SuperSodaSea/Plugcat/README.md

# 🔌Plugcat




- [QSFP-HDMI-OUT-NB7NQ621M v1.1](./QSFP-HDMI-OUT-NB7NQ621M/README.md)
