SuperSodaSea/Plugcat/QSFP-HDMI-OUT-NB7NQ621M/README-zh.md

# QSFP-HDMI-OUT-NB7NQ621M

Module Photo 1

<p align="center">
    <a href="./README.md">English</a> |
    中文
</p>

---




还在为 FPGA 板卡缺少视频输出接口而发愁吗？这款小巧精致的创新模块可以帮您！QSFP-HDMI-OUT-NB7NQ621M 是一款具有 HDMI 输出接口的 QSFP 模块：只需将其插入 FPGA 板卡上的 QSFP 插槽中，即可立即使板卡获得 HDMI 输出功能。这将极大提高您 FPGA 板卡的可扩展性。

## 特性

- 使用 [NB7NQ621M](https://www.onsemi.com/products/signal-conditioning-control/redrivers/NB7NQ621M) 重驱动器芯片，支持HDMI 2.1 视频信号输出，带宽高达 48Gbps
- 提供 HDMI 2.0 TMDS 示例代码，支持 1920x1080@240Hz、2560x1440@144Hz、3840x2160@60Hz 等显示模式
- HDMI 2.1 FRL 待后续提供，您可以使用任意 HDMI 2.1 IP 核

## 引脚描述

| 名称 | 描述 |
|---|---|
| TX1p | HDMI CK+ |
| TX1n | HDMI CK- |
| TX2p | HDMI D0+ |
| TX2n | HDMI D0- |
| TX3p | HDMI D1+ |
| TX3n | HDMI D1- |
| TX4p | HDMI D2+ |
| TX4n | HDMI D2- |
| ModPrsL | 为低电平时，HDMI 线缆为插入状态 |
| ResetL  | 为低电平时，重置 NB7NQ621M |
| SCL | NB7NQ621M 和 HDMI DDC 的 I2C 时钟 |
| SDA | NB7NQ621M 和 HDMI DDC 的 I2C 数据 |

## PCB 信息

- 厚度: 1.00mm
- 叠层结构: JLC04101H-3313

## 已验证的 FPGA 板卡

<table>
  <thead>
    <tr>
      <th>FPGA</th>
      <th>板卡</th>
      <th>示例代码</th>
    </tr>
  </thead>
  <tbody>
    <tr>
      <th colspan="3" scope="rowgroup">Xilinx Zynq 7000 SoC</th>
    </tr>
    <tr>
      <td>XC7Z100</td>
      <td>公子哥 玄武 ZYNQ7100 + FMC 转 QSFP 子板</td>
      <td></td>
    </tr>
    <tr>
      <th colspan="3" scope="rowgroup">Xilinx Kintex Ultrascale</th>
    </tr>
    <tr>
      <td>XCKU060</td>
      <td>Alpha Data ADM-PCIE-KU3</td>
      <td align="center"><a href="./examples/ADM-PCIE-KU3/">🔗</a></td>
    </tr>
    <tr>
      <th colspan="3" scope="rowgroup">Xilinx Virtex Ultrascale</th>
    </tr>
    <tr>
      <td>XCVU095</td>
      <td>BittWare XUS-P3S</td>
      <td></td>
    </tr>
    <tr>
      <th colspan="3" scope="rowgroup">Xilinx Kintex UltraScale+</th>
    </tr>
    <tr>
      <td>XCKU5P</td>
      <td>博宸精芯 KU5P</td>
      <td align="center"><a href="./examples/BoChenJingXin-KU5P/">🔗</a></td>
    </tr>
    <tr>
      <td>XCKU5P</td>
      <td>RIGUKE RK-XCKU5P-F</td>
      <td align="center"><a href="./examples/RK-XCKU5P-F/">🔗</a></td>
    </tr>
    <tr>
      <td>XCKU5P</td>
      <td>米联客 MLK-H8-CU06-KU5P</td>
      <td align="center"><a href="./examples/MLK-H8-CU06-KU5P/">🔗</a></td>
    </tr>
    <tr>
      <th colspan="3" scope="rowgroup">Xilinx Virtex UltraScale+</th>
    </tr>
    <tr>
      <td>XCVU13P</td>
      <td>阿里巴巴 VU13P</td>
      <td align="center"><a href="./examples/Alibaba-VU13P/">🔗</a></td>
    </tr>
    <tr>
      <th colspan="3" scope="rowgroup">Altera Stratix V GS</th>
    </tr>
    <tr>
      <td>5SGSKF40I3LNAC</td>
      <td>微软 Catapult v2 Storey Peak / X930613-001</td>
      <td align="center"><a href="./examples/Storey-Peak/">🔗</a></td>
    </tr>
    <tr>
      <th colspan="3" scope="rowgroup">Altera Arria 10 GX</th>
    </tr>
    <tr>
      <td>10AXF40AA</td>
      <td>微软 Catapult v3 Longs Peak / Model: 1768</td>
      <td align="center"><a href="./examples/Longs-Peak/">🔗</a></td>
    </tr>
    <tr>
      <th colspan="3" scope="rowgroup">Altera Stratix 10 GX</th>
    </tr>
    <tr>
      <td>1SG280LN2F43E2VG</td>
      <td>微软 A-2020</td>
      <td align="center"><a href="./examples/Microsoft-A-2020/">🔗</a></td>
    </tr>
    <tr>
      <th colspan="3" scope="rowgroup">紫光同创 Titan-2</th>
    </tr>
    <tr>
      <td>PG2T390H</td>
      <td>小眼睛泰坦 390H + FMC 转 QSFP 子板</td>
      <td></td>
    </tr>
  </tbody>
</table>

## 示例代码

示例代码在 Windows 与 Linux 下均可构建。

### 依赖工具

- [Python 3](https://www.python.org/)（用于构建脚本）
- [Java](https://www.java.com/)（用于 Chisel）
- [Mill](https://mill-build.org/mill/index.html)（用于 Chisel）
- [Vivado](https://www.amd.com/en/products/software/adaptive-socs-and-fpgas/vivado.html)（用于构建 Xilinx FPGA 工程）
- [Quartus Prime](https://www.intel.com/content/www/us/en/products/details/fpga/development-tools/quartus-prime.html)（用于构建 Altera FPGA 工程）

### 构建示例代码

在对应示例代码目录下运行以下命令即可构建示例代码：

```bash
python build.py build
```

示例代码的默认视频模式为 `1920x1080@60Hz`。若需要更改分辨率和刷新率，可通过命令行参数指定：

```bash
python build.py build --resolution 2560x1440 --refresh-rate 144
```

支持的视频模式：
 - `1920x1080@30/60/120/144/240Hz`
 - `2560x1440@30/60/120/144Hz`
 - `3840x2160@30/60Hz`

其他分辨率可自行修改代码实现。

### 下载位流

```shell
python build.py program
```

### 固化位流

```shell
python build.py flash
```

## 更新日志

见 [CHANGELOG-zh.md](./CHANGELOG-zh.md)。

## 画廊

Module Photo 2
Module Photo 3
