SuperSodaSea/Plugcat/(list of files, cad)

Other CAD files:
QSFP-HDMI-OUT-NB7NQ621M/shell/QSFP-HDMI-OUT-NB7NQ621M-Shell-1.stl
QSFP-HDMI-OUT-NB7NQ621M/shell/QSFP-HDMI-OUT-NB7NQ621M-Shell-2.stl
