SuperSodaSea/Plugcat/QSFP-HDMI-OUT-NB7NQ621M/CHANGELOG.md

# Changelog

## v1.1

QSFP-HDMI-OUT-NB7NQ621M v1.1 is fully compatible with v1.0.

### PCB

- Add KiKit panelization configuration file
- Minor adjustment to circuit routing, optimizing signal quality

### Shell

- Minor adjustment to shell design, enhancing structural stability and manufacturability

## v1.0

Initial release.
