SuperSodaSea/Plugcat/QSFP-HDMI-OUT-NB7NQ621M/CHANGELOG-zh.md

# 更新日志

## v1.1

QSFP-HDMI-OUT-NB7NQ621M v1.1 与 v1.0 完全兼容。

### 电路板

- 添加 KiKit 拼版配置文件
- 微调电路板走线，优化信号质量

### 外壳

- 微调外壳模型，增强结构稳定性和可制造性

## v1.0

初次发布。
