SuperSodaSea/Plugcat/QSFP-HDMI-OUT-NB7NQ621M/board/QSFP-HDMI-OUT-NB7NQ621M.kicad_pcb

## KiCad design QSFP-HDMI-OUT-NB7NQ621M/board/QSFP-HDMI-OUT-NB7NQ621M.kicad_pcb (2026-05-23)

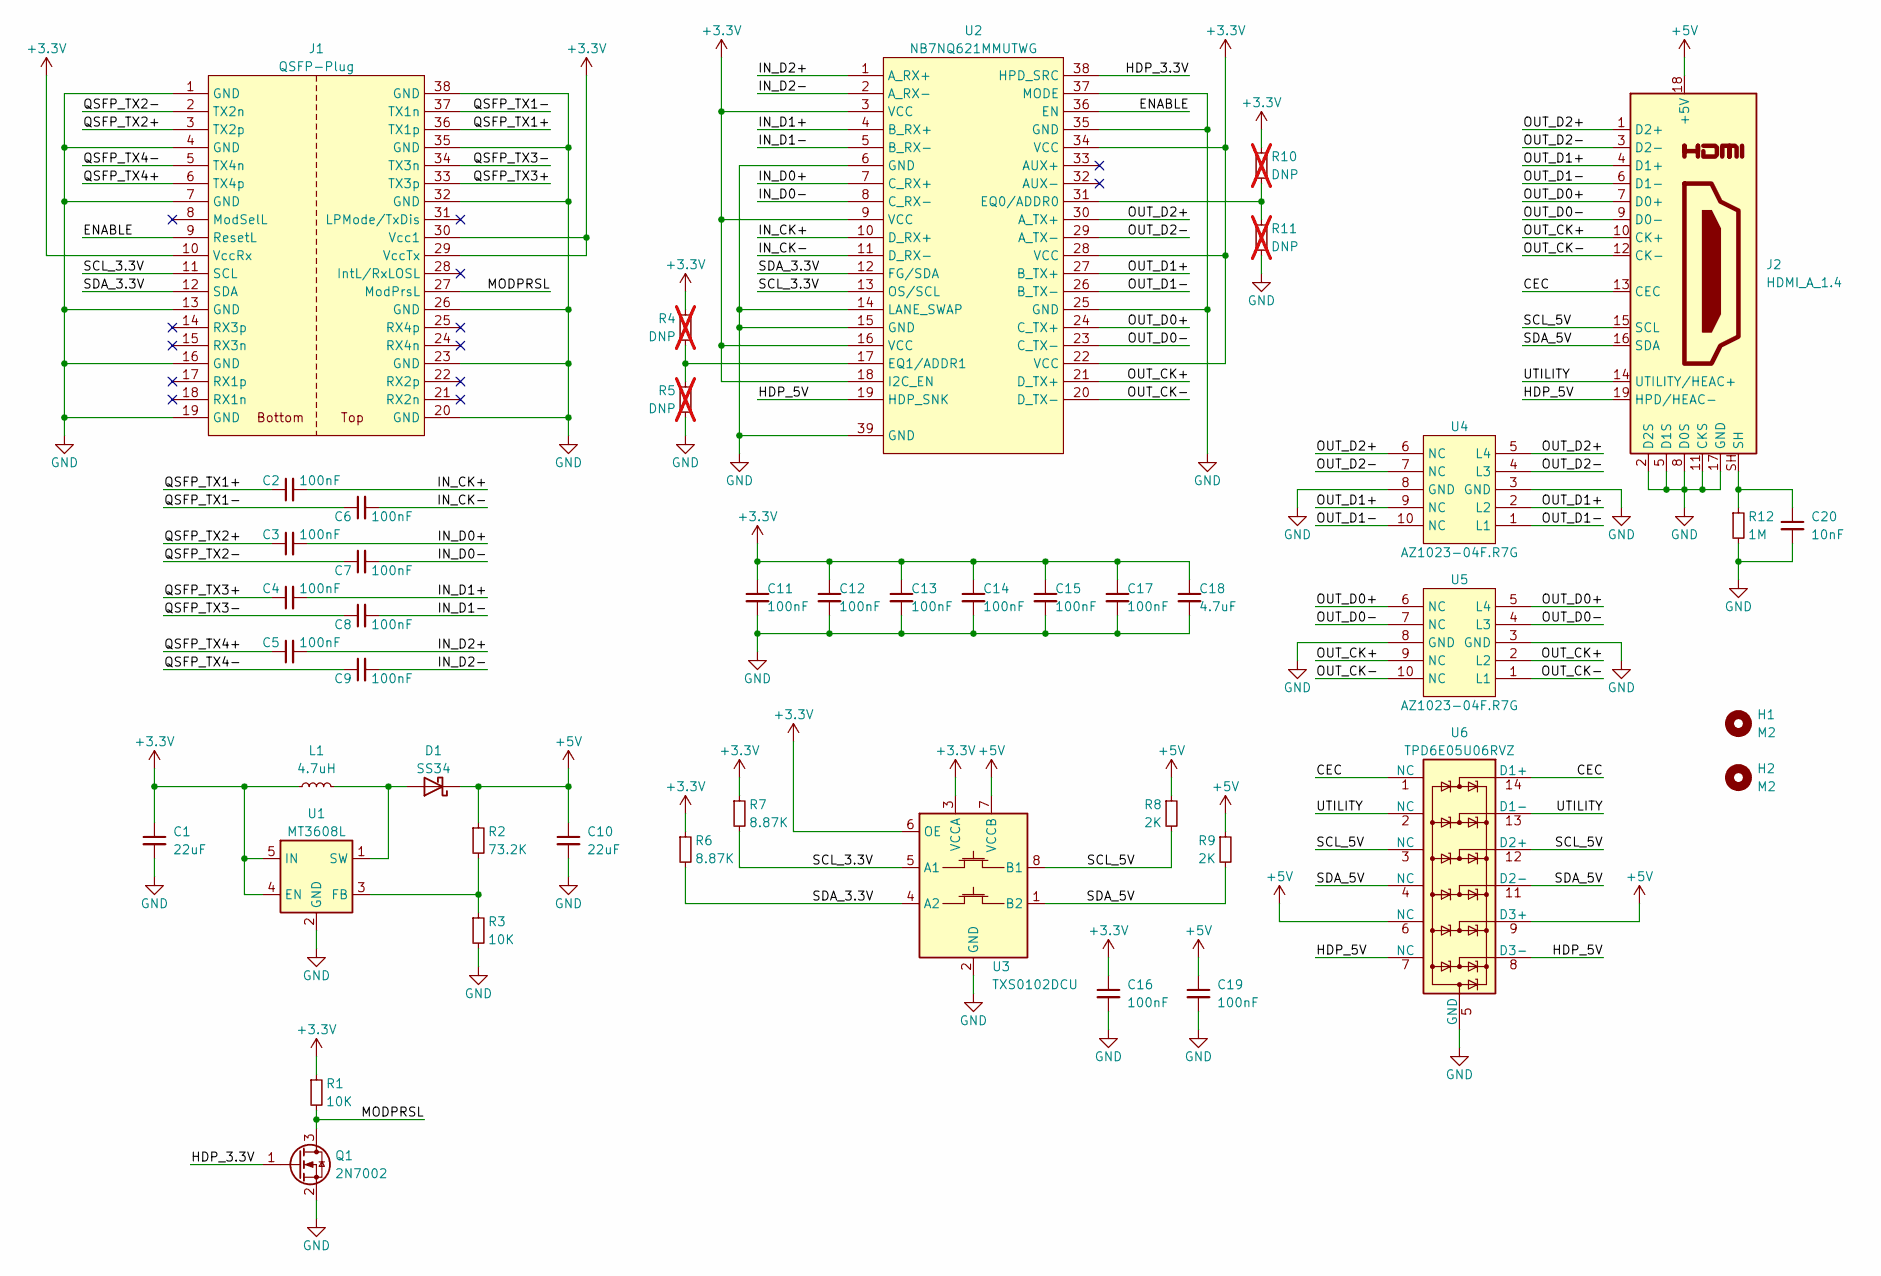
[picture p1: schematic QSFP-HDMI-OUT-NB7NQ621M.kicad_sch]

Parts:
C1, C10: 22uF; C_1206_3216Metric_Pad1.33x1.80mm_HandSolder
C2, C3, C4, C5, C6, C7, C8, C9, C11, C12, C13, C14, C15, C16, C17, C19: 100nF; C_0402_1005Metric_Pad0.74x0.62mm_HandSolder
C18: 4.7uF; C_0603_1608Metric_Pad1.08x0.95mm_HandSolder
C20: 10nF; C_1206_3216Metric_Pad1.33x1.80mm_HandSolder
D1: SS34; D_SMA
H1, H2: M2; MountingHole_1.8mm_M1.6
J1: QSFP-Plug
J2: HDMI_A_1.4; HDMI_A_Molex_208658-1001_Horizontal
L1: 4.7uH; L_Sunlord_SWPA3015S
Q1: 2N7002; SOT-23
R1, R3: 10K; R_0603_1608Metric_Pad0.98x0.95mm_HandSolder
R2: 73.2K; R_0603_1608Metric_Pad0.98x0.95mm_HandSolder
R4, R5, R10, R11: DNP; R_0603_1608Metric_Pad0.98x0.95mm_HandSolder; not fitted
R6, R7: 8.87K; R_0603_1608Metric_Pad0.98x0.95mm_HandSolder
R8, R9: 2K; R_0603_1608Metric_Pad0.98x0.95mm_HandSolder
R12: 1M; R_0603_1608Metric_Pad0.98x0.95mm_HandSolder
U1: MT3608L; SOT-23-6
U2: NB7NQ621MMUTWG; Onsemi_X2QFN38_4.05x4.50mm_P0.4mm
U3: TXS0102DCU; VSSOP-8_2.3x2mm_P0.5mm
U4, U5: AZ1023-04F.R7G; Diodes_UDFN-10_1x2.5mm_P0.5mm
U6: TPD6E05U06RVZ; Texas_R-PUSON-N14

Connections:
+3.3V: C1.1, C11.1, C12.1, C13.1, C14.1, C15.1, C16.1, C17.1, C18.1, J1.10 (VccRx), J1.29 (VccTx), J1.30 (Vcc1), L1.1, R1.1, R4.1, R6.1, R7.1, R10.1, U1.4 (EN), U1.5 (IN), U2.3 (VCC), U2.9 (VCC), U2.16 (VCC), U2.18 (I2C_EN), U2.22 (VCC), U2.28 (VCC), U2.34 (VCC), U3.3 (VCCA), U3.6 (OE)
+5V: C10.1, C19.1, D1.1 (K), J2.18 (+5V), R2.1, R8.1, R9.1, U3.7 (VCCB), U6.6 (NC), U6.9 (D3+)
/CEC: J2.13 (CEC), U6.1 (NC), U6.14 (D1+)
/ENABLE: J1.9 (ResetL), U2.36 (EN)
/HDP_3.3V: Q1.1 (G), U2.38 (HPD_SRC)
/HDP_5V: J2.19 (HPD/HEAC-), U2.19 (HDP_SNK), U6.7 (NC), U6.8 (D3-)
/IN_CK+: C2.2, U2.10 (D_RX+)
/IN_CK-: C6.2, U2.11 (D_RX-)
/IN_D0+: C3.2, U2.7 (C_RX+)
/IN_D0-: C7.2, U2.8 (C_RX-)
/IN_D1+: C4.2, U2.4 (B_RX+)
/IN_D1-: C8.2, U2.5 (B_RX-)
/IN_D2+: C5.2, U2.1 (A_RX+)
/IN_D2-: C9.2, U2.2 (A_RX-)
/MODPRSL: J1.27 (ModPrsL), Q1.3 (D), R1.2
/OUT_CK+: J2.10 (CK+), U2.21 (D_TX+), U5.2 (L2), U5.9 (NC)
/OUT_CK-: J2.12 (CK-), U2.20 (D_TX-), U5.1 (L1), U5.10 (NC)
/OUT_D0+: J2.7 (D0+), U2.24 (C_TX+), U5.5 (L4), U5.6 (NC)
/OUT_D0-: J2.9 (D0-), U2.23 (C_TX-), U5.4 (L3), U5.7 (NC)
/OUT_D1+: J2.4 (D1+), U2.27 (B_TX+), U4.2 (L2), U4.9 (NC)
/OUT_D1-: J2.6 (D1-), U2.26 (B_TX-), U4.1 (L1), U4.10 (NC)
/OUT_D2+: J2.1 (D2+), U2.30 (A_TX+), U4.5 (L4), U4.6 (NC)
/OUT_D2-: J2.3 (D2-), U2.29 (A_TX-), U4.4 (L3), U4.7 (NC)
/QSFP_TX1+: C2.1, J1.36 (TX1p)
/QSFP_TX1-: C6.1, J1.37 (TX1n)
/QSFP_TX2+: C3.1, J1.3 (TX2p)
/QSFP_TX2-: C7.1, J1.2 (TX2n)
/QSFP_TX3+: C4.1, J1.33 (TX3p)
/QSFP_TX3-: C8.1, J1.34 (TX3n)
/QSFP_TX4+: C5.1, J1.6 (TX4p)
/QSFP_TX4-: C9.1, J1.5 (TX4n)
/SCL_3.3V: J1.11 (SCL), R7.2, U2.13 (OS/SCL), U3.5 (A1)
/SCL_5V: J2.15 (SCL), R8.2, U3.8 (B1), U6.3 (NC), U6.12 (D2+)
/SDA_3.3V: J1.12 (SDA), R6.2, U2.12 (FG/SDA), U3.4 (A2)
/SDA_5V: J2.16 (SDA), R9.2, U3.1 (B2), U6.4 (NC), U6.11 (D2-)
/UTILITY: J2.14 (UTILITY/HEAC+), U6.2 (NC), U6.13 (D1-)
GND: C1.2, C10.2, C11.2, C12.2, C13.2, C14.2, C15.2, C16.2, C17.2, C18.2, C19.2, C20.2, J1.1 (GND), J1.4 (GND), J1.7 (GND), J1.13 (GND), J1.16 (GND), J1.19 (GND), J1.20 (GND), J1.23 (GND), J1.26 (GND), J1.32 (GND), J1.35 (GND), J1.38 (GND), J2.2 (D2S), J2.5 (D1S), J2.8 (D0S), J2.11 (CKS), J2.17 (GND), Q1.2 (S), R3.2, R5.2, R11.2, R12.2, U1.2 (GND), U2.6 (GND), U2.14 (LANE_SWAP), U2.15 (GND), U2.25 (GND), U2.35 (GND), U2.37 (MODE), U2.39 (GND), U3.2 (GND), U4.3 (GND), U4.8 (GND), U5.3 (GND), U5.8 (GND), U6.5 (GND), U6.10 (GND)
unnamed: C20.1, J2.SH, R12.1
unnamed: D1.2 (A), L1.2, U1.1 (SW)
unnamed: R2.2, R3.1, U1.3 (FB)
unnamed: R10.2, R11.1, U2.31 (EQ0/ADDR0)
unnamed: R4.2, R5.1, U2.17 (EQ1/ADDR1)

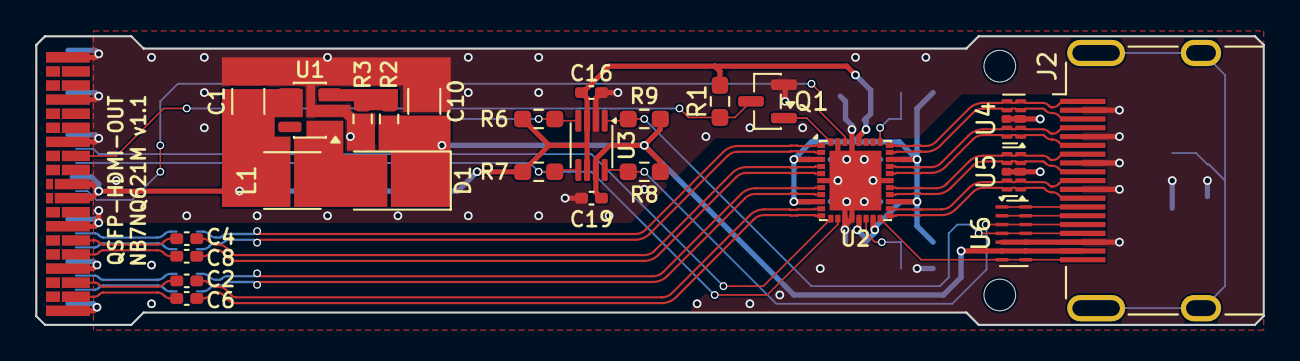
[picture p2: board QSFP-HDMI-OUT-NB7NQ621M.kicad_pcb from above]

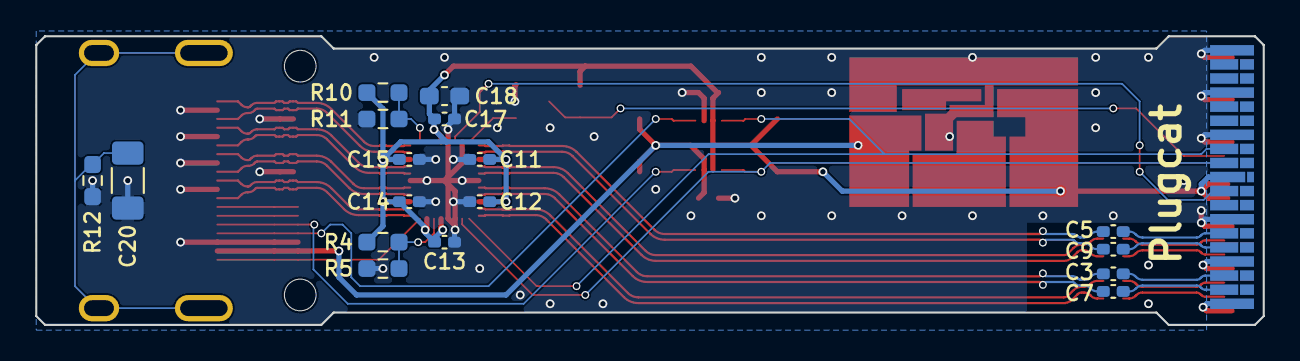
[picture p3: board QSFP-HDMI-OUT-NB7NQ621M.kicad_pcb from below]

Board: 4 copper layers, 69.7 x 16.4 mm, 45 parts (17 on the bottom side), 42 nets.
