SuperSodaSea/Plugcat/common/Vivado/constraints/Alibaba-VU13P/Config.xdc

set_property CFGBVS GND [current_design]
set_property CONFIG_VOLTAGE 1.8 [current_design]
set_property CONFIG_MODE SPIx4 [current_design]
set_property BITSTREAM.CONFIG.CONFIGRATE 102.0 [current_design]
set_property BITSTREAM.CONFIG.EXTMASTERCCLK_EN Disable [current_design]
set_property BITSTREAM.CONFIG.SPI_32BIT_ADDR Yes [current_design]
set_property BITSTREAM.CONFIG.SPI_BUSWIDTH 4 [current_design]
set_property BITSTREAM.CONFIG.SPI_FALL_EDGE Yes [current_design]
set_property BITSTREAM.CONFIG.UNUSEDPIN Pullnone [current_design]
set_property BITSTREAM.GENERAL.COMPRESS True [current_design]
