SuperSodaSea/Plugcat/common/Vivado/constraints/ADM-PCIE-KU3/LED.xdc

set_property PACKAGE_PIN AE12 [get_ports led[0]]
set_property PACKAGE_PIN AF12 [get_ports led[1]]
set_property PACKAGE_PIN AD11 [get_ports led[2]]
set_property IOSTANDARD LVCMOS33 [get_ports led[*]]
