SuperSodaSea/Plugcat/(commit log)

2025-03-09 Update KiCAD QSFP-Plug symbol
    [QSFP-HDMI-OUT-NB7NQ621M.kicad_sch]
2025-03-13 Bump mill to 0.12.8
2025-03-16 I2CMaster: Support read request
2025-04-02 HDMIOUTExample: Fix HDMI 2.0 check not working
    [HDMIOUTExample.v]
2025-04-08 I2CMaster: Add arbitration support
2025-04-10 QSFP-HDMI-OUT-NB7NQ621M: Add Storey-Peak example code
    [Config.cfg]
2025-04-10 QSFP-HDMI-OUT-NB7NQ621M: Add Longs-Peak example code
    [Config.cfg]
2025-05-31 QSFP-HDMI-OUT-NB7NQ621M: Update README Use table in "Verified FPGA Boards" section
2025-06-02 KiCad: Upgrade files to 9.0
    [QSFP-HDMI-OUT-NB7NQ621M.kicad_pcb, QSFP-HDMI-OUT-NB7NQ621M.kicad_sch]
2025-06-02 KiCad: Rename KiCAD -> KiCad
2025-09-19 Chisel: Upgrade mill to 1.0.5 & chisel to 7.0.0
2025-09-24 QSFP-HDMI-OUT-NB7NQ621M: Update footprints
    [QSFP-HDMI-OUT-NB7NQ621M.kicad_pcb, QSFP-HDMI-OUT-NB7NQ621M.kicad_sch]
2025-11-10 QSFP-HDMI-OUT-NB7NQ621M: Update to v1.1
    [QSFP-HDMI-OUT-NB7NQ621M-Shell-1.stl, QSFP-HDMI-OUT-NB7NQ621M-Shell-2.stl, QSFP-HDMI-OUT-NB7NQ621M.kicad_pcb]
2026-05-23 Misc: Update to KiCad 10.0
    [QSFP-HDMI-OUT-NB7NQ621M.kicad_pcb, QSFP-HDMI-OUT-NB7NQ621M.kicad_sch]
2026-06-26 KiCad: Use v10 .kicad_symdir format
